robhannan/fun-house-pinball/docs/sound-credits.md

# Sound credits

The recorded sounds in `sim/web/samples/` are cut from these recordings. The
effects come from [Freesound](https://freesound.org) and are
[CC0 1.0](https://creativecommons.org/publicdomain/zero/1.0/); the attract-mode
music comes from [Wikimedia Commons](https://commons.wikimedia.org) and is in
the public domain. No credit is required, but thank you to everyone who shared
them.

This file is generated from `sim/samples/sources.json` by
`pnpm run import:samples`; edit that file, not this one.

| Recording | By | Licence | Used for |
|---|---|---|---|
| [nipit_play_bells.wav](https://freesound.org/people/relwin/sounds/172266/) | relwin | CC0 1.0 | Pop bumper, Lane chime, 30 points, Player added, Bonus advance 20, Bonus advance 30, Bonus advance 40, Bonus advance 50, Bonus advance 60, Bonus advance 70, Bonus advance 80, Bonus advance 90, Bonus advance 100, Bell: 1s, Bell: 10s, Bell: 100s |
| [Drum Roll, Please!](https://freesound.org/people/HoBoTrails/sounds/424927/) | HoBoTrails | CC0 1.0 | Bonus collect |
| [crash Zildjian 16 inches bassized very long 2](https://freesound.org/people/Logicogonist/sounds/807997/) | Logicogonist | CC0 1.0 | Bonus collect |
| [Fanfare.wav](https://freesound.org/people/ricniclas/sounds/449069/) | ricniclas | CC0 1.0 | Special lit |
| [wood hammer, gavel, knock, pound, jury, court.mp3](https://freesound.org/people/JohnsonBrandEditing/sounds/173941/) | JohnsonBrandEditing | CC0 1.0 | Replay (knocker) |
| [Relay and loud click](https://freesound.org/people/bassmosphere/sounds/384701/) | bassmosphere | CC0 1.0 | Tilt, Coil noise: kicker |
| [Motor whirs then clicks and chimes](https://freesound.org/people/bassmosphere/sounds/384699/) | bassmosphere | CC0 1.0 | Game start |
| [A relay switch being activated.](https://freesound.org/people/bassmosphere/sounds/384698/) | bassmosphere | CC0 1.0 | Player added |
| [Popping Cork](https://freesound.org/people/milcahrawr/sounds/622150/) | milcahrawr | CC0 1.0 | Ball serve |
| [classic dizzy take slide whistle.wav](https://freesound.org/people/martian/sounds/403002/) | martian | CC0 1.0 | Ball serve |
| [SLIDE WHISTLE - 2](https://freesound.org/people/SamuelGremaud/sounds/517632/) | SamuelGremaud | CC0 1.0 | Drain |
| [Instant Drain](https://freesound.org/people/bassmosphere/sounds/384702/) | bassmosphere | CC0 1.0 | Drain, Trapdoor |
| [wah wah sad trombone.wav](https://freesound.org/people/kirbydx/sounds/175409/) | kirbydx | CC0 1.0 | Game over |
| [Julius Fučík's "Entrance of the Gladiators", performed by the United States Marine Band](https://commons.wikimedia.org/wiki/File:Julius_Fu%C4%8D%C3%ADk%27s_%22Entrance_of_the_Gladiators%22,_performed_by_the_United_States_Marine_Band.flac) | United States Marine Band (c. 1999) | Public domain (work of the US government; composed 1897) | Attract music |
| [pinball-flipper hits.wav](https://freesound.org/people/schafferdavid/sounds/450270/) | schafferdavid | CC0 1.0 | Coil noise: kicker, Coil noise: pop bumper, Coil noise: flipper |
