robhannan/fun-house-pinball/(commit log)

2026-10-13 Add Rust/Arduino Mega 2560 project skeleton (#1)
    * Add Rust/Arduino Mega 2560 project skeleton
    - pinball-core: no_std, host-testable game logic (debounced switch matrix,
    coil driver with pulse/recycle safety limits, lamps, game state machine)
    - firmware: avr-hal based Mega 2560 binary with 1 ms tick, switch scanning,
    74HC595 output chain, watchdog and fail-safe panic handler
    - CI (fmt, clippy, tests, AVR build), dependabot, hardware docs
    * Add pull request template
    ---------
    [clock.rs, coils.rs, game.rs, io.rs, lamps.rs, lib.rs, main.rs, playfield.rs]
2026-10-13 Map the real Fun House playfield and card scoring (#2)
    Replace the generic EM placeholders with the features visible on the
    1956 playfield: five pop bumpers, kicking rubbers, top and side lanes,
    the Scores Bonus gate, 30-points rollovers and the 10-100 bonus wheel.
    Score on the original 1950s scale, with replays at the instruction
    card's 400/600/700/800/900 thresholds.
    [game.rs, lamps.rs, playfield.rs]
2026-10-13 Add beginner wiring guide and playfield map; fix 74HC595 SPI mode (#4)
    * Drive the 74HC595 chain with SPI mode 0 at 1 MHz
    avr-hal defaults to SPI mode 1, where data changes on the rising clock
    edge that the 74HC595 samples on, so outputs could be scrambled or
    shifted by one. Use mode 0, and slow the clock to 1 MHz for margin on
    long playfield wiring.
    * Add beginner wiring guide and playfield map
    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
    [main.rs]
2026-10-15 Add the three trapdoors under the Scores Bonus gate (#7)
    Each trapdoor has a switch and a continuous-duty flap coil. Flaps are
    closed for every new ball, on tilt and game over, and once a ball drops
    through. What opens them on the original is still unknown, so the rules
    expose Machine::set_trapdoor for now.
2026-10-16 Add parts-list tests and a stray-files check (#32)
    * Add CI checks for failures found so far
    - PARTS in playfield.rs lists every part with its switch, coils and
    lamp. Tests check that no switch, coil or lamp is shared, that every
    configured coil belongs to a part and vice versa, and that pulse coils
    have a 1-100 ms limit.
    - PR checks workflow: the description has Summary and Notes, no leftover
    template comments, and a GIF that loads and isn't the placeholder.
    Changing COIL_KINDS requires the description to mention the rating.
    - Branch checks workflow: fails pushes to a branch whose PR is already
    merged.
    - CI fails if build output or .DS_Store files are committed.
    - CLAUDE.md: ke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
    [playfield.rs]
2026-10-16 Switch from npm to pnpm (#33)
    - package.json pins pnpm 12.11.2 (packageManager); pnpm-lock.yaml
    replaces package-lock.json.
    - CI uses pnpm/setup@v3, which installs pnpm, Node.js from .nvmrc and
    the locked dependencies in one step, replacing setup-node and npm ci.
    - CLAUDE.md: use pnpm, not npm.
2026-10-16 Add a browser simulator for the game logic (#30)
    * Add a browser simulator for the game logic
    pinball-sim wraps the real Machine with a simulated clock and switches
    and exports a small numeric API to WebAssembly. The page in sim/web
    draws docs/playfield.svg, turns clicks and keys into switch closures,
    and lights lamps, flashes coils and raises flippers from the outputs.
    Trapdoor flaps can be opened by hand until the rule is known (#24).
    Tests keep the SVG's data-switch/coil/lamp attributes in step with
    playfield.rs. CI builds the simulator.
    * Simulator: show short coil pulses, safer keyboard handling
    From a fresh-context review of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
    [lib.rs]
2026-10-16 Add sound: recorded EM pinball effects mixed by a WAV Trigger, optional real bells (#35)
    * Add sound: classic pinball and circus effects via a DFPlayer Mini
    - pinball-core: a Sound enum with track numbers, priorities and
    durations; a SoundScheduler that plays one sound at a time, letting
    more important sounds win; DFPlayer Mini command frames (checksum
    tested against the datasheet). The rules request sounds for bumpers,
    kickers, lanes, the bonus wheel, bonus collect, special, replays,
    tilt, game start and over, players joining, ball serve, drain and the
    trapdoors.
    - Firmware: DFPlayer on USART1 (D18/D19), sending one byte per tick so
    the 9600-baud port never stalls the main lo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
    [bells.rs, game.rs, io.rs, lib.rs, main.rs, playfield.rs, sound.rs]
2026-10-17 Add looping attract music with a light show in time to it (#36)
    * Add looping attract music with a light show in time to it
    - Music: a seamless 64-beat loop of 'Entrance of the Gladiators'
    (Fucik, 1897) played by the United States Marine Band (public domain,
    from Wikimedia Commons). It starts 5 s into attract mode and loops
    until a game starts, which stops it. Settings::attract_music turns it
    off.
    - import:samples finds the beats (122 BPM), picks the loop length whose
    following harmony best matches the start (chroma), crossfades the
    seam, and generates crates/pinball-core/src/music_beats.rs.
    - Light show (attract.rs): the playfield and backboard lamps change on
    every beat, wit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
2026-10-17 Correct the playfield map from clearer photos (#37)
    * Correct the playfield map from clearer photos
    The top centre is a "10 when lit" pop bumper, not a passive red bumper;
    the four "top lanes" are two striped "advance bonus when lit" rubbers, with
    passive jack-in-the-box rebounds in the corners. There's no separate
    "Scores Bonus" gate: a ball through a trapdoor collects the bonus, and each
    trapdoor has a lamp above it. "30 points when lit" is a lamp below each of
    the four side lanes, not a pair of rollovers, with an "advance bonus" lamp
    below each pair.
    * Add the side kickers under the lower pop bumpers
    Each red lower pop bumper sit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
    [attract.rs, game.rs, playfield.rs, sound.rs]
2026-10-17 Add an operator test mode for switches, coils and lamps (#40)
    * Add an operator test mode for switches, coils and lamps
    A test button inside the coin door (direct input 5) steps through three
    stages from attract mode: switches (each one rings a bell, lights its
    part's lamp and is reported by name), coils (flippers choose, Start fires
    the chosen one once), and lamps (flippers step through them, Start lights
    them all). The firmware prints each report on the USB console through a
    non-blocking queue, and the simulator shows the same lines.
    Also stops Coils::pulse restarting a pulse that's still running, which
    could stretch it past the coil's limit.
    Closes #15.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
    [coils.rs, game.rs, io.rs, lib.rs, main.rs, playfield.rs, test_mode.rs]
2026-10-17 Add ball physics to the simulator (#41)
    * Add ball physics to the simulator
    One ball rolls down the sloped playfield, launched with a plunger and kept
    alive with the flippers. Its geometry comes from docs/playfield.svg (parts by
    their data attributes, walls by a new data-wall), and it's driven by the real
    coil outputs: touching a pop bumper closes its switch, the core fires the
    coil, and the coil kicks the ball. Flippers, kickers, trapdoors and the ball
    serve work the same way.
    The map gains the apron walls (no outlanes, a V into the outhole) and a
    one-way shooter gate; the side kickers and jack-in-the-boxes move so a ball
    can pass the walls, and the outer lane rails and guide rails give w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
    [lib.rs]
2026-10-17 Turn the trapdoor flaps with servos instead of coils (#42)
    * Turn the trapdoor flaps with servos instead of coils
    The owner's table is missing its trapdoor mechanisms, so they're rebuilt with
    a hobby servo per flap. The core now outputs an angle per flap (from each
    flap's closed and open trims) instead of holding coils 12-14, which become
    spare. The firmware drives the servos from Timer 3 in hardware on D5, D2
    and D3, and test mode gains a flaps stage that moves each flap to its closed
    and open positions and trims them a degree at a time. The trims are saved in
    the EEPROM when test mode ends.
    The wiring guide gets a build section (wiring, a flush hinged flap, chute and
    switch, setting the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
    [flaps.rs, game.rs, lib.rs, main.rs, playfield.rs, servo.rs, test_mode.rs]
2026-10-21 Add a 3D-printed ball return, with collision checks (#43)
    * Add OpenSCAD models for the 3D-printed trapdoor parts
    Each trapdoor is a frame that slides up into its hole and carries the
    servo, a flap hinged on a 2 mm pin, a lifter arm on the servo that the flap
    rests on (up holds it flush, back lets it open), and a chute that catches
    the ball with a microswitch under its floor. All the table's measurements
    live in measurements.scad (placeholders until measured) so the parts always
    fit each other; the chute's exit, drop, slope and length are Customizer
    options; assembly.scad shows them together, open or closed, cut in half.
    pnpm run export:3d writes the STLs, and check:3d renders every model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
    [assembly.scad, ball_lift.scad, ball_lift_cup.scad, ball_lift_exit.scad, ball_paths.scad, common.scad, measurements.scad, outhole_funnel.scad]
2026-10-21 Serve a ball again when the serve falls short (#45)
    * Serve a ball again when the serve falls short
    A ball that drops back onto the outhole switch before reaching the shooter
    lane (or hitting anything) is served again instead of ending the ball. After
    MAX_SERVES tries the ball ends as before, so a jammed ball lift can't fire its
    coil for ever. Closes #44.
    * Test that a playfield hit alone puts the ball in play
    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
    [game.rs]
2026-10-23 Split the specialist parts into a bench-test round and a later round (#46)
    * Split the specialist parts into a bench-test round and a later round
    The first round is what's needed to bring up the coil drivers on the bench
    and to measure the printed ball return's parts: an FL-11722 left flipper
    assembly, an AE-26-1200 slingshot coil with its sleeve and plunger, a bat,
    pinballs and the ball-serve coil. The rest waits for the playfield survey
    and a test fit of the first flipper. Totals updated to match.
    * Warn about coil supply peaks, and drop the stale flipper coil price
    Review of #46: the first-round coils draw more than the LRS-350-4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
2026-10-24 Recommend power parts that UK consumers can buy (#51)
    Mouser won't sell the Mean Well LRS supplies to UK consumers. Every supply is now an enclosed Mean Well GST desktop adaptor with a C14 inlet (GST280A48-C6P for the coils, GST60A07-P1J for the lamps, GST25A09-P1J for the Arduino, GST60A05-P1J for sound and servos), from RS or Rapid, which sell to individuals. The marketplace mains adaptors, inlet, fuse holders and DC switch move to RS and Rapid too, and the list adds the mains leads, multi-socket and barrel adaptors they need. The coil supply is 280 W, so the list says to check the kick peaks on the bench. Totals updated; the old high total was £5 out.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
2026-10-28 Add the both-flippers supply check, and match the guide to the new supplies (#52)
    Review of #51: wiring guide step 7 now checks the 280 W coil supply with both flippers kicking at once, which the shopping list already pointed to. The lamp supply is a fixed 7.5 V rather than adjustable, the 5 V adaptors are no longer 2 A and 3 A, and the coil supply note says to unplug it before cutting its plug and that its -V is earthed.
2026-10-28 Add an ordered option to the parts tracker (#56)
    * Add an ordered option to the parts tracker
    Each part gets an Ordered toggle for what's on its way. Ordered parts show
    as On order, have their own filter, and are counted apart from what's still
    to order. Getting the full amount takes a part off order.
    got.json becomes { got: { id: count }, ordered: [id] }. The page still
    reads the old flat file, and writes the new shape on its next save.
    The format and state logic moves to site/parts/counts.js, tested by
    counts.test.mjs in test:site. The build no longer copies test files into
    the site.
    * Save the tracker to parts.json so an old ope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
2026-10-29 Call out the easier, less-soldering alternatives in the shopping list (#57)
    * Call out the easier, less-soldering alternatives in the shopping list
    Each part that a ready-made alternative replaces now says so in its notes,
    pointing to a paragraph under its section:
    - an assembled Mega screw-terminal shield, rather than a kit
    - 74HC595 modules, for the chips, sockets and capacitors (new). They must
    bring OE out on its own pin; many tie it to ground, which would defeat the
    pull-up that keeps the outputs off at power-on and while flashing.
    - MOSFET driver boards, for the MOSFETs, resistors and screw terminals. They
    now also have to be active high, so the coils are off when the 74HC595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
2026-10-29 List the easier alternatives as rows, so the parts tracker shows them (#58)
    * List the easier alternatives as rows, so the parts tracker shows them
    The notes on the replaced parts pointed "below" to paragraphs that only the
    Markdown shows; the tracker shows table rows alone, so the alternatives were
    nowhere on it. The 74HC595 module (14) and the 8-channel MOSFET driver board
    (3) are now Optional rows in sections 4 and 5, out of the totals as the
    tracker treats optional parts, each with its key safety check in its notes.
    The replaced parts' notes name those rows, and the paragraphs under each
    table keep the full checks.
    Existing item names are unchanged, so saved counts still match.
    Co-Aut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
2026-10-31 Draw the playfield map to scale, from the real table's measurements (#59)
    * Draw the playfield map to scale, from the real table's measurements
    The map is now in millimetres, with the board's back-left corner at the
    origin. The board, the arch's ends, the shooter lane and the centres of
    the bumpers, trapdoors, rollovers, bonus wheel, flipper pivots, centre
    post and outhole come from tape measurements of the table; other shapes
    are fitted around them and marked as assumed. The ball is its real 27 mm.
    The simulator's tests now find parts on the map instead of hard-coding
    their positions, and the page reads the ball's size from the
    WebAssembly.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
    [lib.rs]
2026-10-31 Add a playfield tracer: correct the map's shapes from a photo (#60)
    * Add a playfield tracer: correct the map's shapes from a photo
    The map's measured parts now carry data-measured labels. The tracer page
    (sim/web/trace/) asks you to click those parts on a photo of the table,
    fits a homography to the clicks, straightens the photo onto the map in
    millimetres and shows each click's error. You then drag the map's
    assumed shapes onto the photo and download a playfield.svg in which only
    the edited attributes change. The photo never leaves the browser.
    The fit and the shape editing are in their own modules, tested with
    node --test (run by pnpm run test:site), and a Rust test checks the map
    has e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
    [lib.rs]
2026-10-31 Add the 12.7 mm wall along the playfield's left edge (#61)
    * Add the 12.7 mm wall along the playfield's left edge
    With walls on both sides the playable area runs from 12.7 to 459 mm,
    centred on 235.9 mm, which matches the measured centreline of the parts.
    * List the left wall among the map's measurements
    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
2026-10-31 Use the traced playfield shapes, and curve the shooter lane to its gate (#62)
    * Use the traced playfield shapes
    The jack-in-the-box kickers, top rubbers, side kickers, kicking rubbers,
    the special lamp's arrow and the lamps are traced from a photo with the
    playfield tracer, and the arch's radius (253.3 mm) with them. The
    measured walls and the apron edge stay as measured, and matching lamps
    share one size. The kicking rubbers' corners by the flippers are pulled
    back so a cradled ball doesn't set them off, and the cradle test now
    checks the ball really is by the pivot.
    * Curve the shooter lane round with the arch to the gate
    The lane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
    [lib.rs]
2026-11-01 Fit the 3D-printed ball return to the measured table (#63)
    * Fit the 3D-printed ball return to the measured table
    measurements.scad now has the table's measurements: the playfield (520 x
    1079 mm, 13.5 mm thick), the trapdoor holes (30.5 x 65 mm, 65.5 mm
    apart), the outhole (37.8 mm, 95 mm from the front) and the shooter lane
    (35 mm wide, its 12.9 mm wall at 459 mm). The flaps are topped with the
    1 mm metal plates.
    The holes are only 3.5 mm wider than the ball, so the trapdoors change:
    - one frame per hole, with a 1 mm sleeve, so each fits the printer;
    - the flap's rib moves from its edge to its middle, keeping the same
    linkage, so the catch box gets the hole's full width; the link passes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
    [ball_paths.scad, common.scad, measurements.scad, parts_overlap.scad, placement.scad, trapdoor_collector.scad, trapdoor_flap.scad, trapdoor_frame.scad]
